kuninet/KZ80-MESMEM/README.md

# KZ80シリーズ用 偽MSX1 専用メモリーボード

## 概要

* KZ80-CPUBなどを使って偽MSX1を構成するためのメモリーボードです。
* メモリーICのチップセレクト信号は、[KZ80-MSXCTRG](https://github.com/kuninet/KZ80-MSXCTRG)ボードに載っているMSXスロット信号で制御します。かならずペアで使用してください。

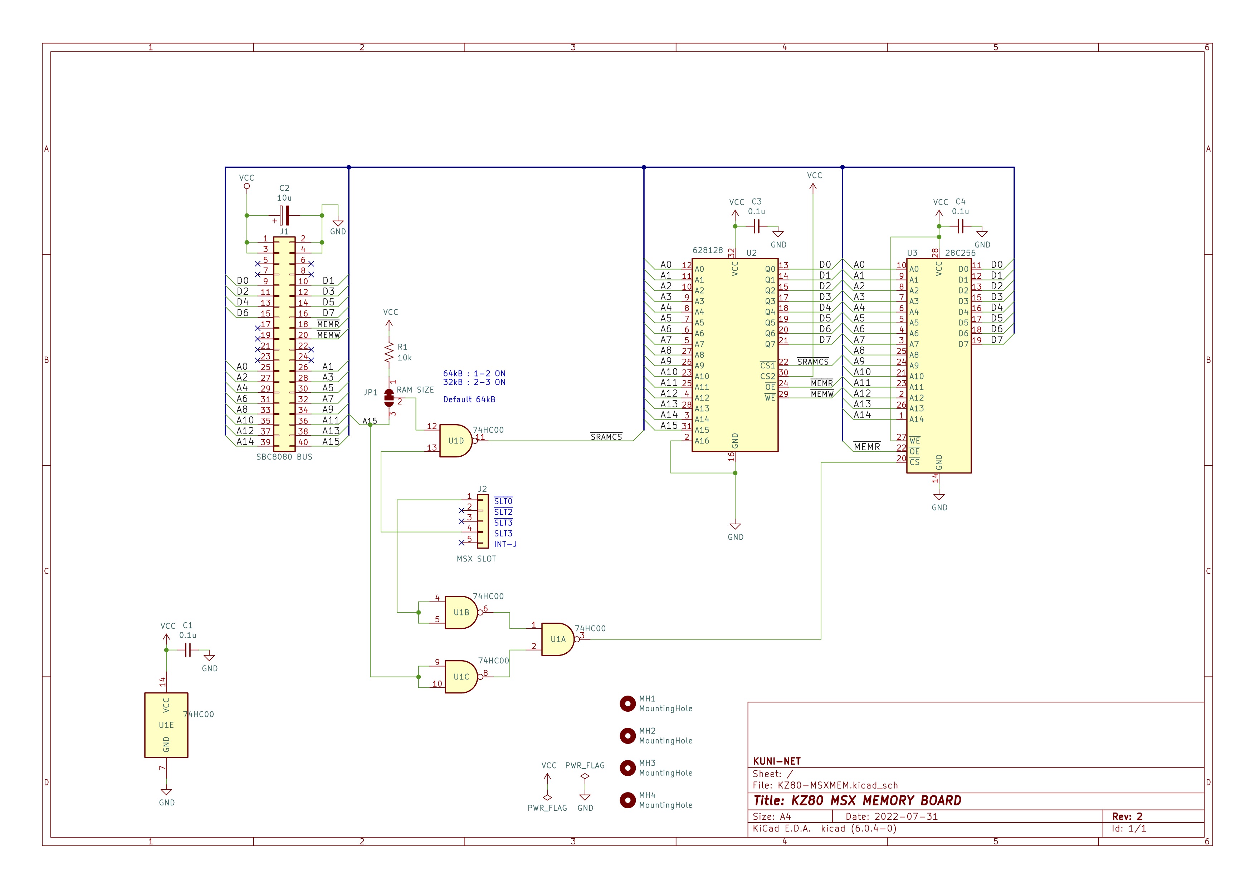
[picture p1: image/KZ80-MSXMEM.jpg]
回路図
