kuninet/KZ80-MESMEM/image/KZ80-MSXMEM.pdf

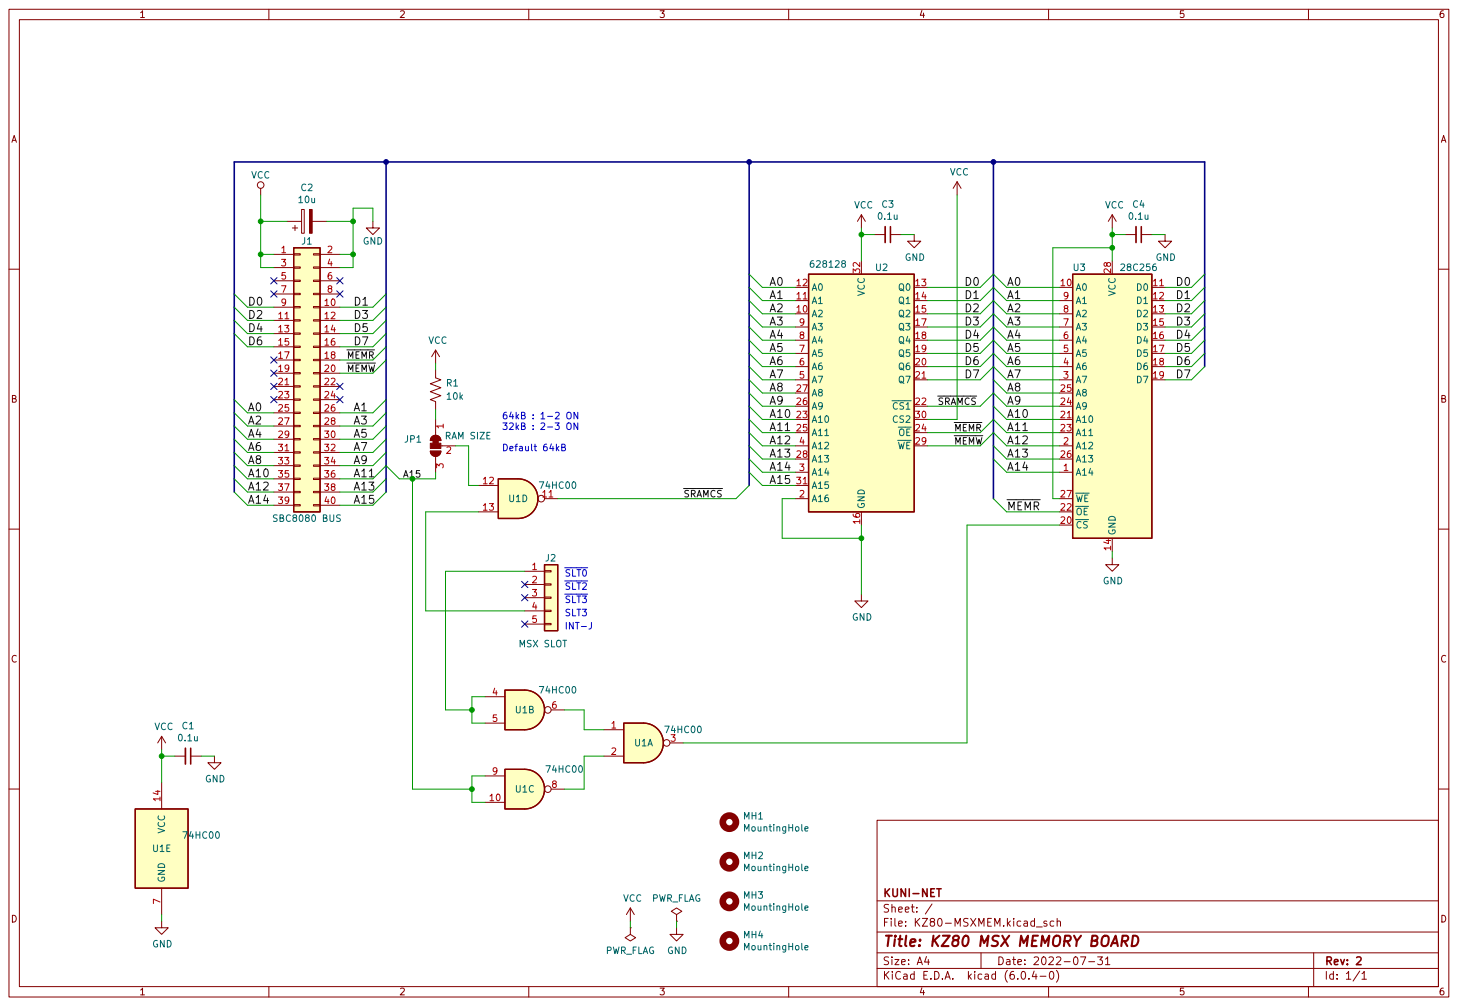
[picture p2: page 1]

J2 MSX SLOT VCC 14 GND

File: KZ80-MSXMEM.kicad_sch Sheet: / KUNI-NET MH4 MountingHole

Id: 1/1 Title: KZ80 MSX MEMORY BOARD
