kuninet/KZ80-MESMEM/参考/スロット構成.pdf

# KZ80-MSXMEM

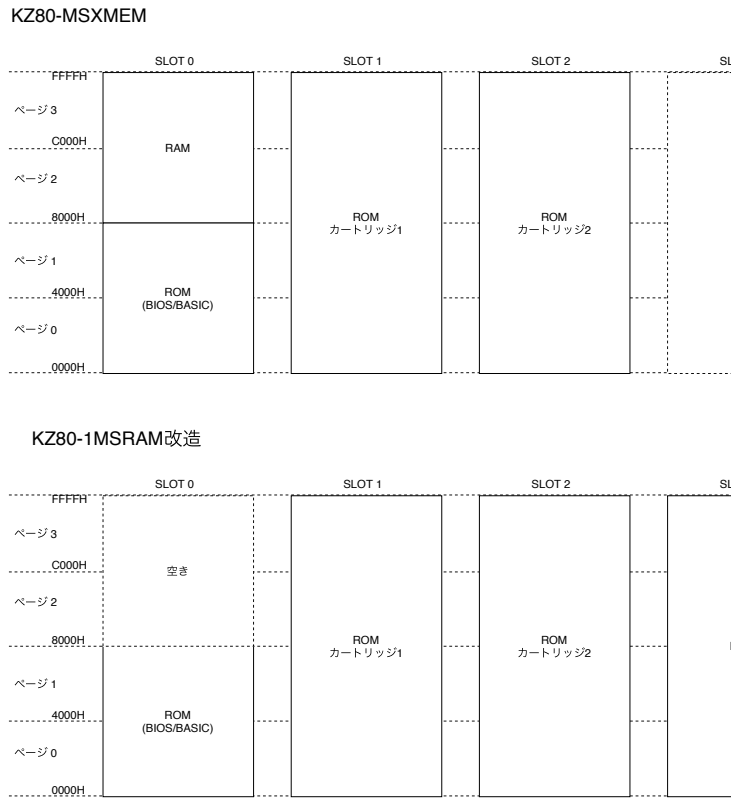
[picture p3: page 1]
RAM; ROM (BIOS/BASIC); ROM カートリッジ1; ROM カートリッジ2; SLOT 0; SLOT 1; SLOT 2; FFFFH; ページ 0; ページ 1; ページ 2; ページ 3; KZ80-1MSRAM改造
