kuninet/KZ80-MESMEM/(list of files, drawings)

Other design files:
KiCAD/KZ80-MSXMEM.dsn
参考/スロットデコーダ.circ
