kuninet/KZ80-MESMEM/KiCAD/KZ80-MSXMEM.kicad_pcb

## KiCad design KiCAD/KZ80-MSXMEM.kicad_pcb (2022-11-05)

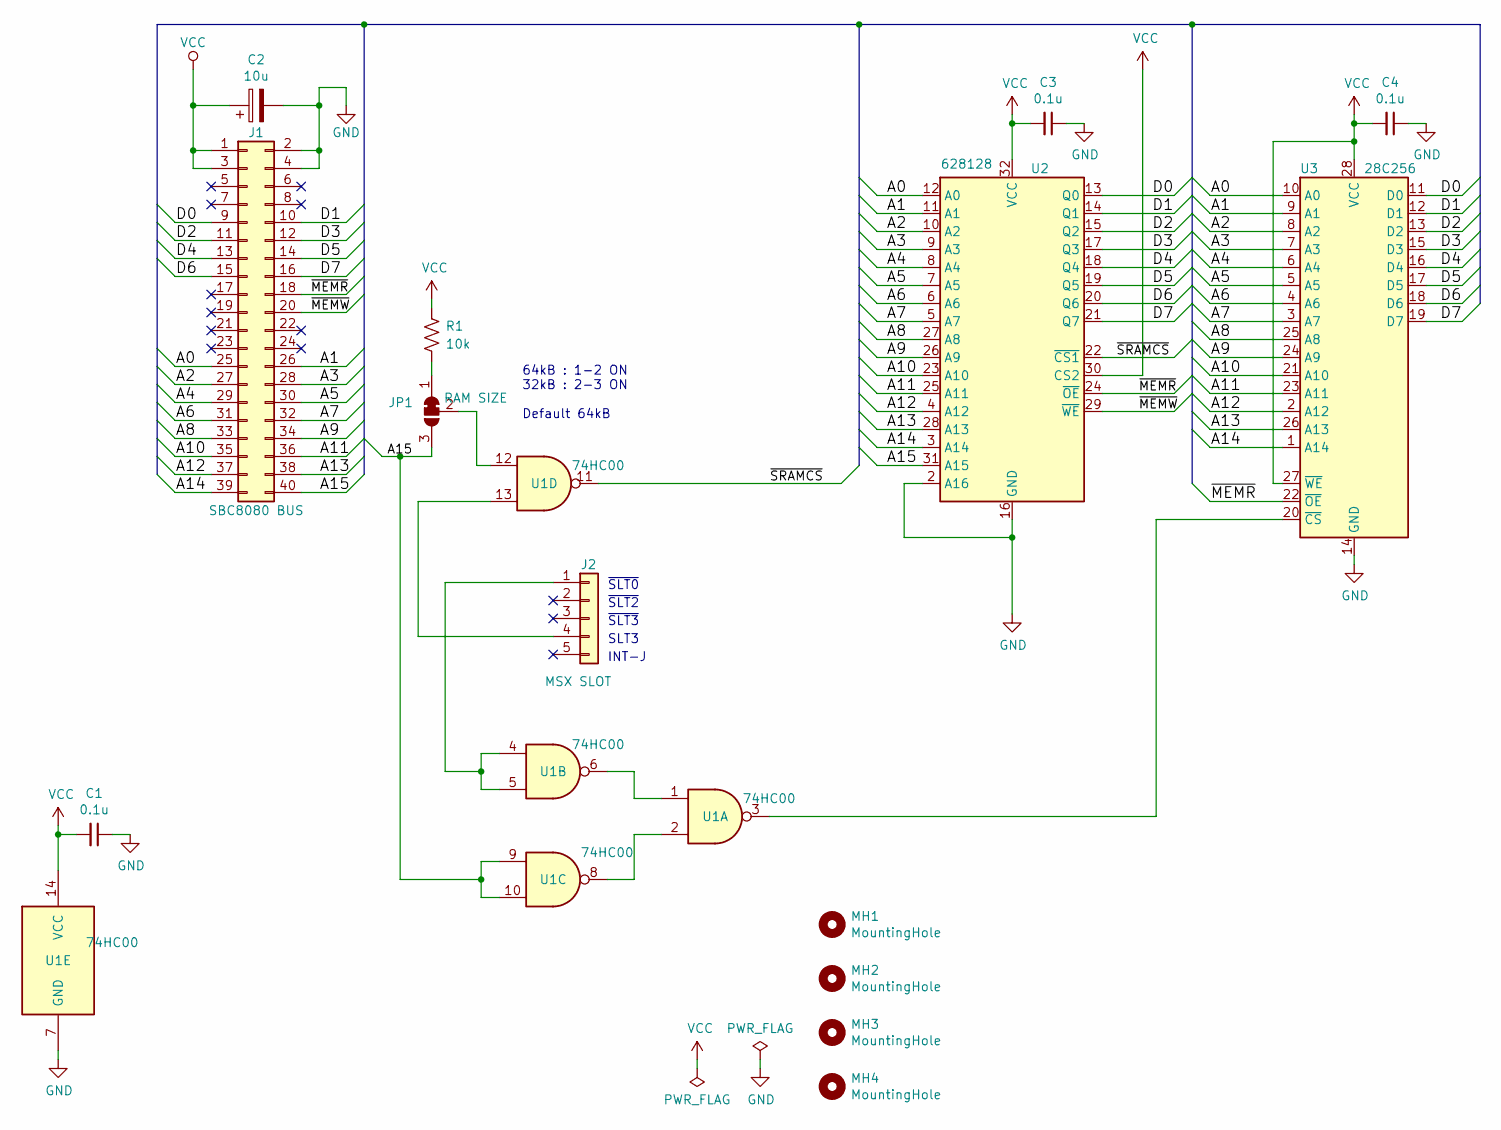
[picture p4: schematic KZ80-MSXMEM.kicad_sch, KZ80 MSX MEMORY BOARD]

Parts:
C1, C3, C4: 0.1u; C_Disc_D3.0mm_W1.6mm_P2.50mm
C2: 10u; CP_Radial_D5.0mm_P2.50mm
J1: SBC8080 BUS; PinHeader_2x20_P2.54mm_Horizontal
J2: MSX SLOT; PinHeader_1x05_P2.54mm_Horizontal
JP1: RAM SIZE
MH1, MH2, MH3, MH4: MountingHole; MountingHole_3.2mm_M3
R1: 10k
U1: 74HC00; DIP-14_W7.62mm_Socket_LongPads
U2: 628128
U3: 28C256; DIP-28_W15.24mm_Socket_LongPads

Connections:
/A0: J1.25, U2.12 (A0), U3.10 (A0)
/A1: J1.26, U2.11 (A1), U3.9 (A1)
/A2: J1.27, U2.10 (A2), U3.8 (A2)
/A3: J1.28, U2.9 (A3), U3.7 (A3)
/A4: J1.29, U2.8 (A4), U3.6 (A4)
/A5: J1.30, U2.7 (A5), U3.5 (A5)
/A6: J1.31, U2.6 (A6), U3.4 (A6)
/A7: J1.32, U2.5 (A7), U3.3 (A7)
/A8: J1.33, U2.27 (A8), U3.25 (A8)
/A9: J1.34, U2.26 (A9), U3.24 (A9)
/A10: J1.35, U2.23 (A10), U3.21 (A10)
/A11: J1.36, U2.25 (A11), U3.23 (A11)
/A12: J1.37, U2.4 (A12), U3.2 (A12)
/A13: J1.38, U2.28 (A13), U3.26 (A13)
/A14: J1.39, U2.3 (A14), U3.1 (A14)
/A15: J1.40, JP1.3 (B), U1.9, U1.10, U2.31 (A15)
/D0: J1.9, U2.13 (Q0), U3.11 (D0)
/D1: J1.10, U2.14 (Q1), U3.12 (D1)
/D2: J1.11, U2.15 (Q2), U3.13 (D2)
/D3: J1.12, U2.17 (Q3), U3.15 (D3)
/D4: J1.13, U2.18 (Q4), U3.16 (D4)
/D5: J1.14, U2.19 (Q5), U3.17 (D5)
/D6: J1.15, U2.20 (Q6), U3.18 (D6)
/D7: J1.16, U2.21 (Q7), U3.19 (D7)
/~MEMR: J1.18, U2.24 (~OE), U3.22 (~OE)
/~MEMW: J1.20, U2.29 (~WE)
/~SRAMCS: U1.11, U2.22 (~CS1)
GND: C1.1, C2.2, C3.1, C4.1, J1.2, J1.4, U1.7 (GND), U2.2 (A16), U2.16 (GND), U3.14 (GND)
unnamed: J2.1, U1.4, U1.5
unnamed: J2.4, U1.13
unnamed: JP1.1 (A), R1.2
unnamed: JP1.2 (C), U1.12
unnamed: U1.1, U1.6
unnamed: U1.2, U1.8
unnamed: U1.3, U3.20 (~CS)
VCC: C1.2, C2.1, C3.2, C4.2, J1.1, J1.3, R1.1, U1.14 (VCC), U2.30 (CS2), U2.32 (VCC), U3.27 (~WE), U3.28 (VCC)

Notes on the sheet:
~{SLT3}
~{SLT2}
SLT3
INT-J
~{SLT0}
64kB : 1-2 ON 32kB : 2-3 ON Default 64kB

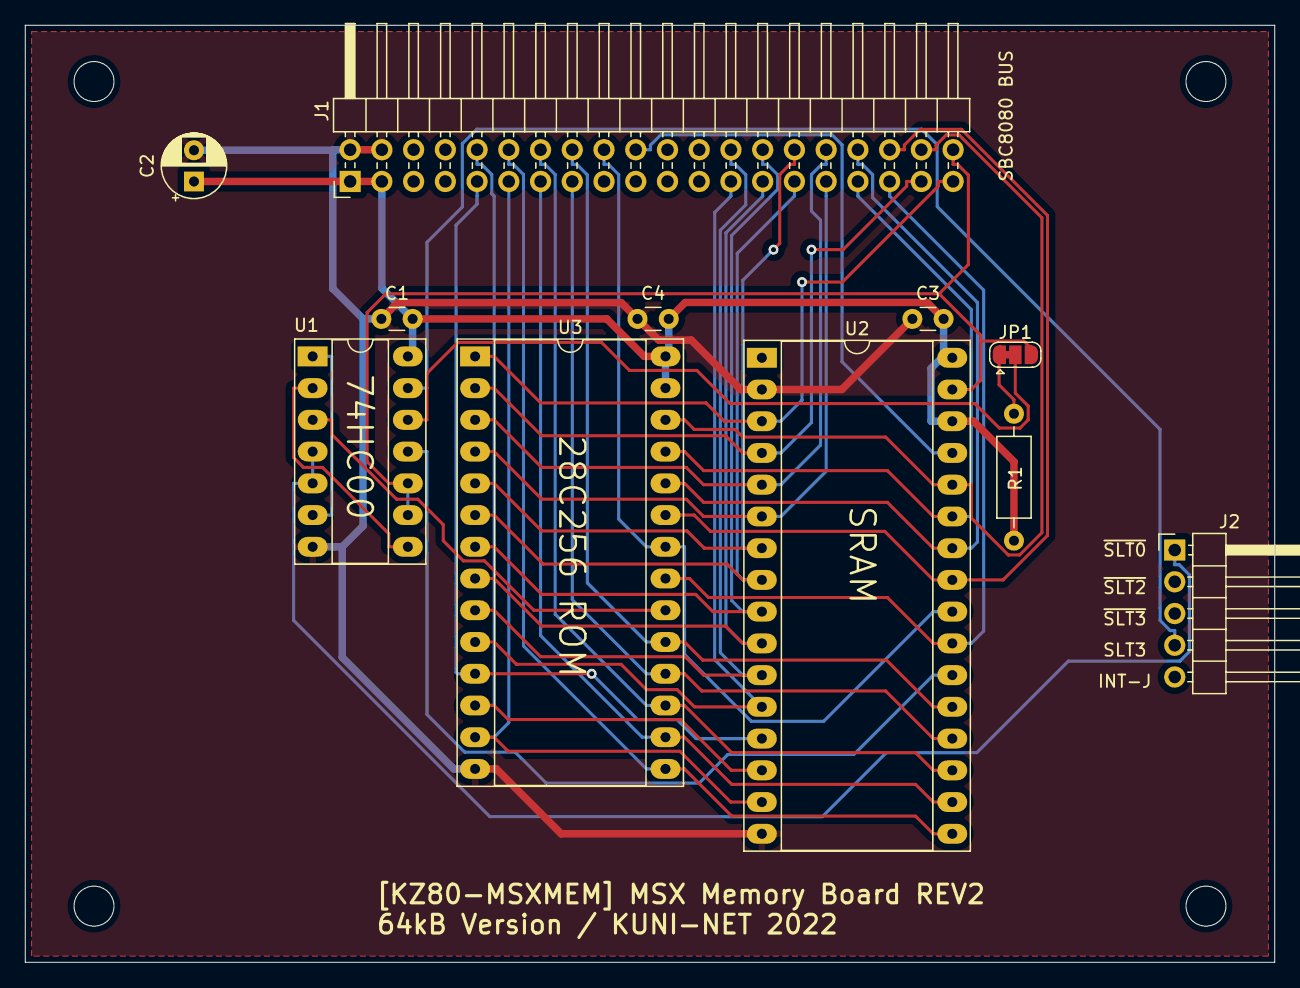
[picture p5: board KZ80-MSXMEM.kicad_pcb from above]

Board: 2 copper layers, 100.0 x 75.0 mm, 15 parts (0 on the bottom side), 36 nets.
