kuninet/KZ80-MESMEM/(commit log)

2021-12-18 README追加など
    [スロットデコーダ.circ]
2022-11-05 REV2 64kB Version ガーバー出力
    [KZ80-MSXMEM-B_Cu.gbl, KZ80-MSXMEM-B_Mask.gbs, KZ80-MSXMEM-B_Silkscreen.gbo, KZ80-MSXMEM-F_Cu.gtl, KZ80-MSXMEM-F_Mask.gts, KZ80-MSXMEM-F_Silkscreen.gto, KZ80-MSXMEM.GBL, KZ80-MSXMEM.GBO]
2022-11-05 REV2 ガーバー再出力
    [KZ80-MSXMEM-B_Silkscreen.gbo, KZ80-MSXMEM-F_Silkscreen.gto, KZ80-MSXMEM.GBL, KZ80-MSXMEM.GBO, KZ80-MSXMEM.GBP, KZ80-MSXMEM.GBS, KZ80-MSXMEM.GKO, KZ80-MSXMEM.GTL]
2024-04-28 部品表 追加
    [KZ80-MSXMEM.csv]
